uncertainty-cc/Recoil-Motor-Controller/hardware/README.md

### TODOs

 - [ ] Add more caps to 12V rail and over voltage diode to prevent voltage spike shoot through AMS1117.
