uncertainty-cc/Recoil-Motor-Controller/firmware/README.md

## TODO

 - [ ] DOCS: finish documentation for motor_controller.h and motor_controller.c
 - [ ] ADD: implement velocity control loop in PositionController
 - [ ] ADD: implement host machine software (Web GUI)
 - [ ] ADD: implement LUT linearization for encoder position reading
 - [ ] ADD: implement acceleration and velocity controlled trajectory generation
 - [ ] ADD: safety feature, temperature sense and over-temperature shutdown
