uncertainty-cc/Recoil-Motor-Controller/sim/current_domain.gif

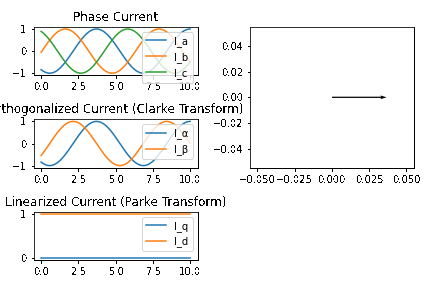
sim/current_domain.gif
