uncertainty-cc/Recoil-Motor-Controller/sim/voltage_domain.gif

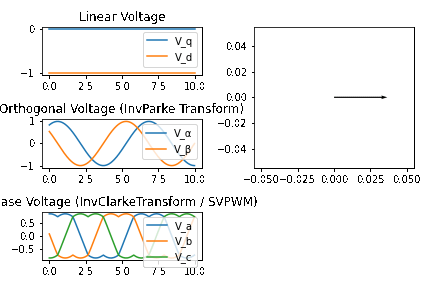
sim/voltage_domain.gif
