uncertainty-cc/Recoil-Motor-Controller/hardware/Recoil-Motor-Controller-G431-DRV8350RS/Schematic_Recoil Motor Controller G431 DRV8350RS v1.1.pdf

## Microcontroller

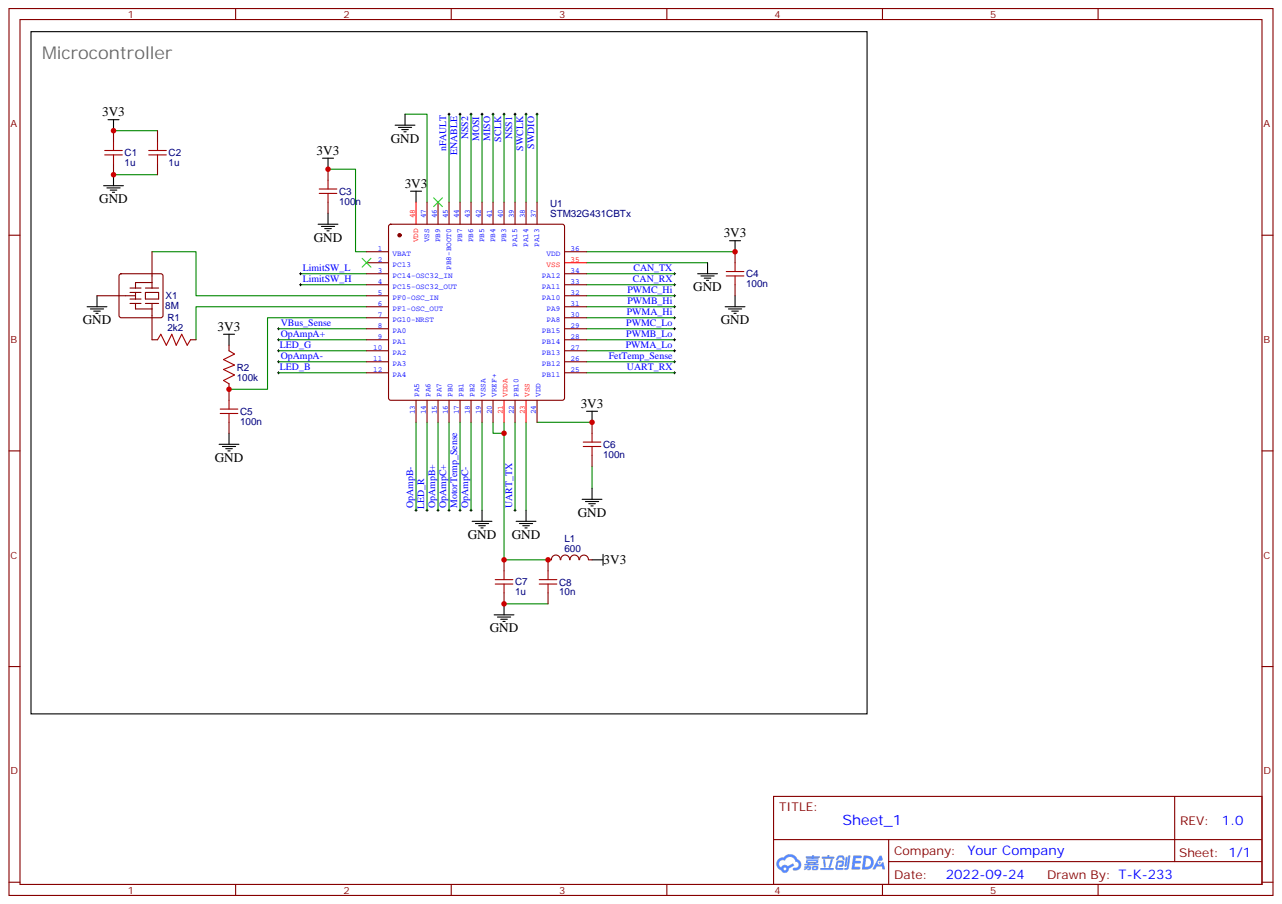
[picture p3: page 1]

## CAN

## CAN Transciever

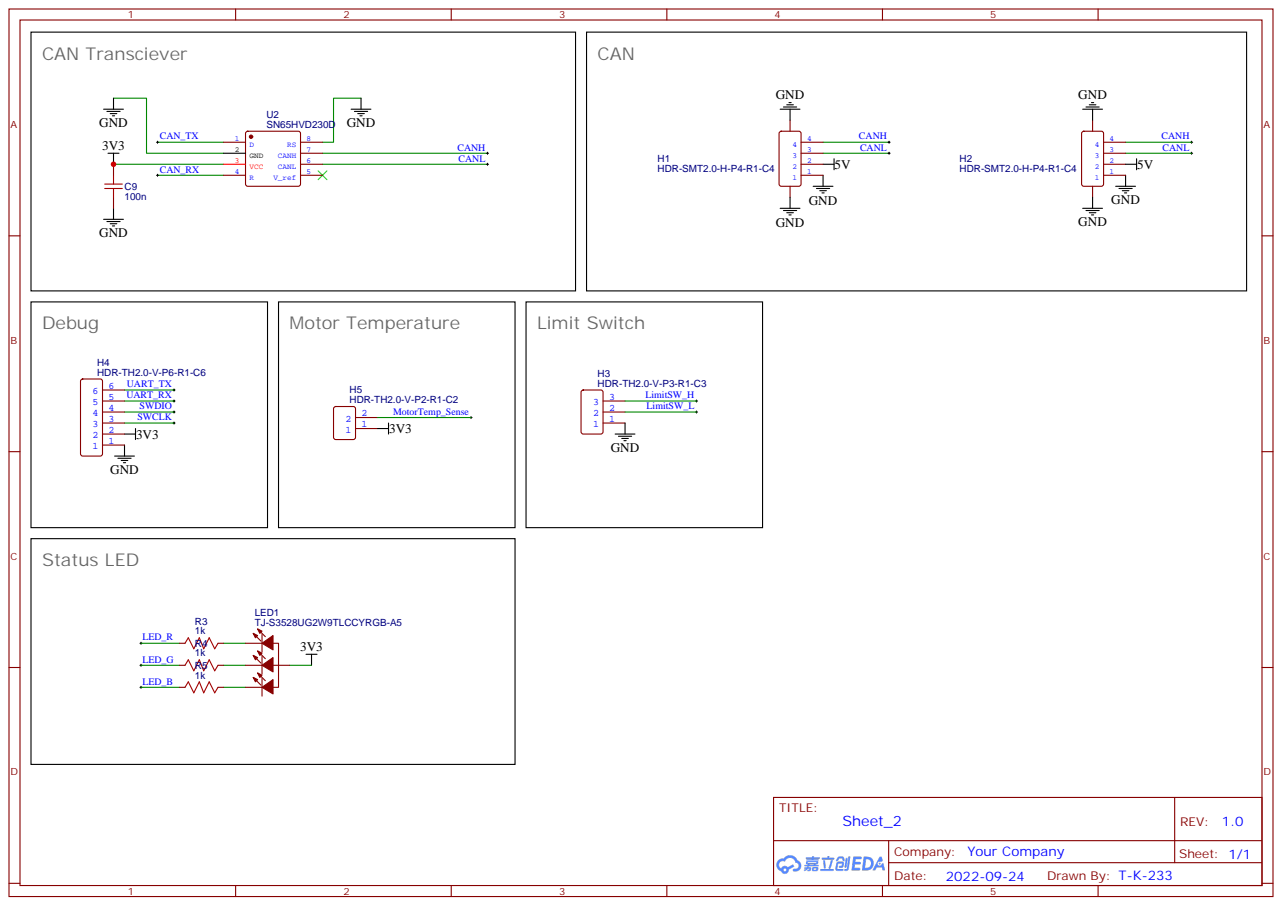
[picture p4: page 2]

## 3V3 Supply

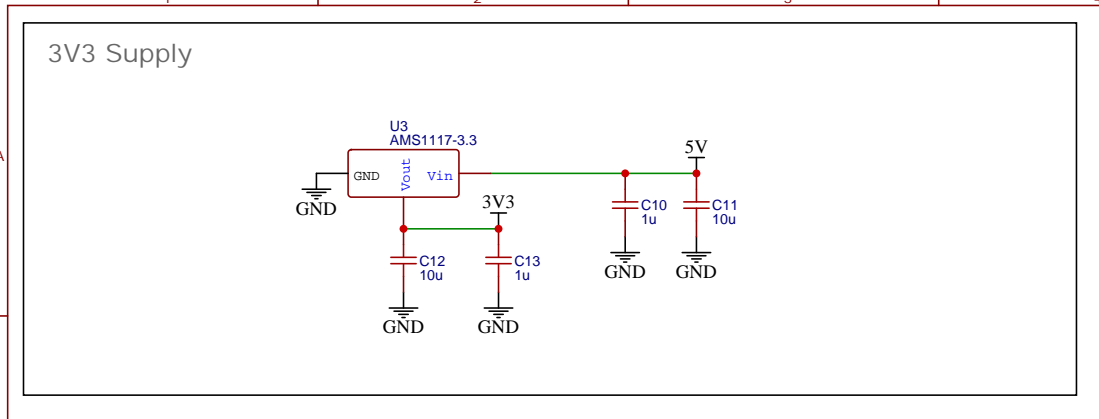
[picture p5: page 3]

## Gate Driver

## Bulk Caps

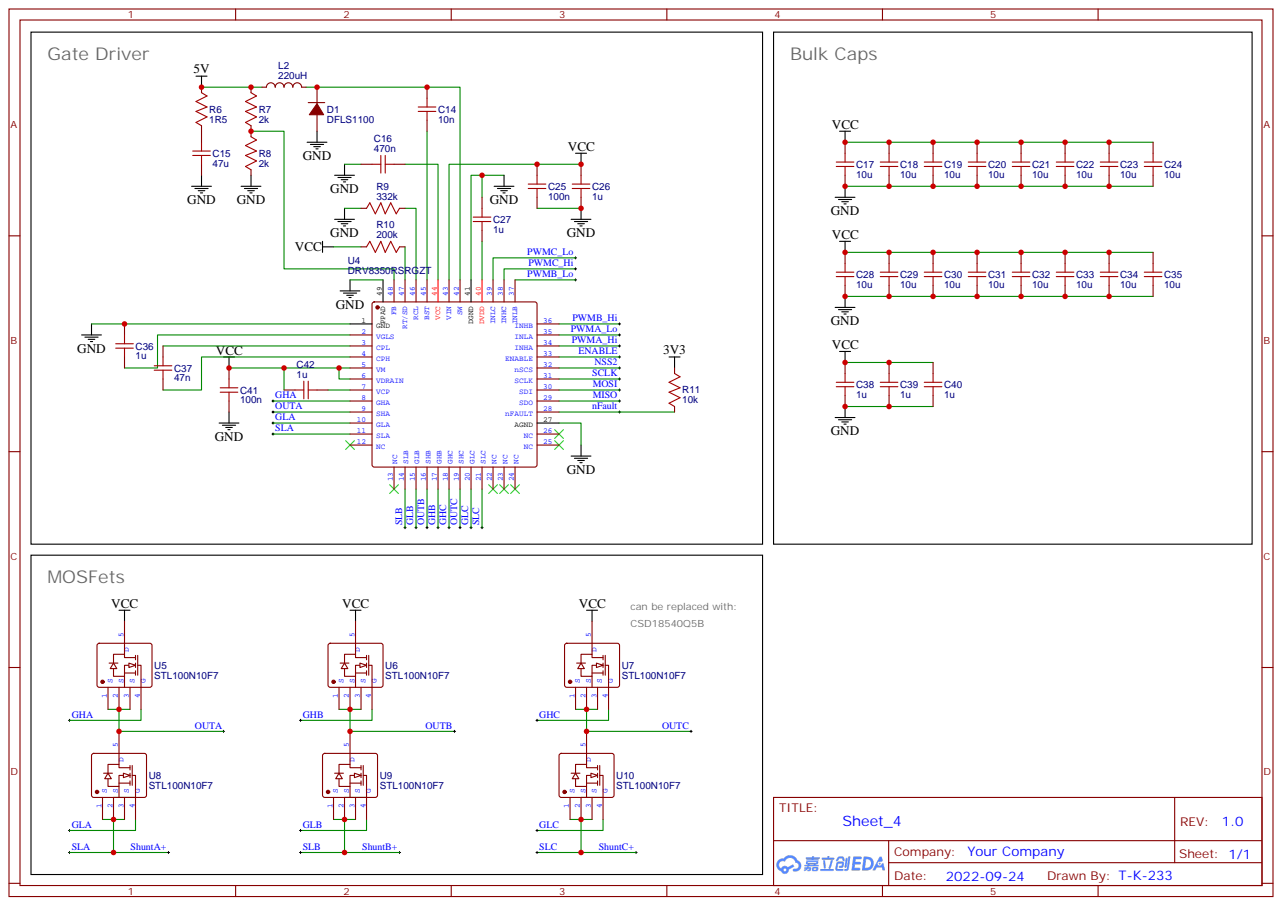
[picture p6: page 4]

can be replaced with:
CSD18540Q5B

## Current Sense

## Voltage Sense

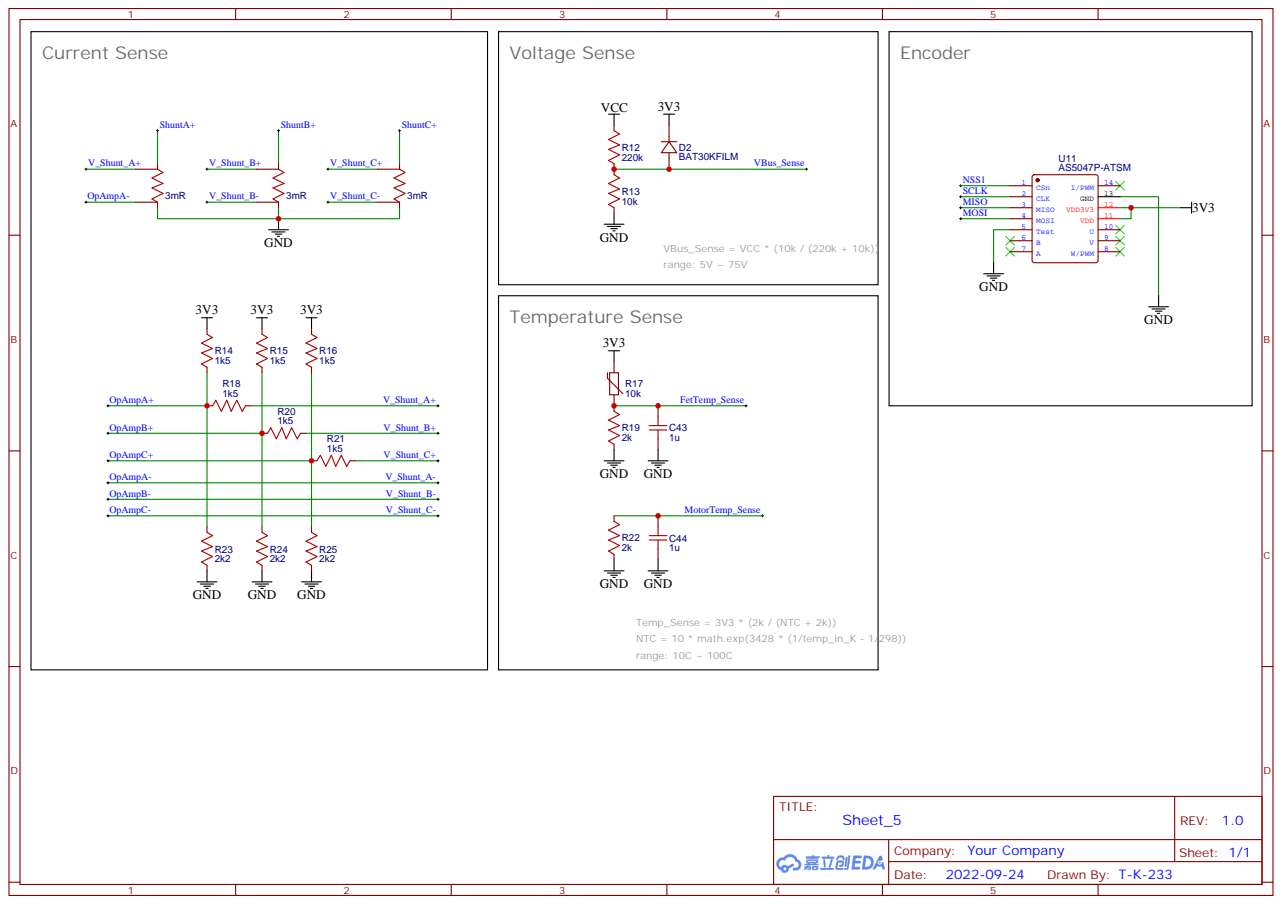
[picture p7: page 5]
