uncertainty-cc/Recoil-Motor-Controller/(list of files, drawings)

Other design files:
hardware/Recoil-Motor-Controller-G431-DRV8350RS/PCB_Recoil Motor Controller G431 DRV8350RS v1.1.pcbdoc
