uncertainty-cc/Recoil-Motor-Controller/firmware/Recoil-Motor-Controller-B-G431B-ESC1/Core/Inc/main.h

#define GPIO_CAN_TERM_Pin GPIO_PIN_14
#define GPIO_CAN_TERM_GPIO_Port GPIOC
#define ADC_POT_Pin GPIO_PIN_12
#define ADC_POT_GPIO_Port GPIOB
#define GPIO_BUTTON_Pin GPIO_PIN_10
#define GPIO_BUTTON_GPIO_Port GPIOC
