uncertainty-cc/Recoil-Motor-Controller/firmware/Recoil-Motor-Controller-B-G431B-ESC1/Core/Src/current_controller.c

#include "current_controller.h"


HAL_StatusTypeDef CurrentController_init(CurrentController *controller) {
  controller->i_limit = 20.f;

  // kp ki should be set through CAN bus.
  // kp = bandwidth * 2 * pi * phase_inductance
  // ki = phase_resistance / phase_inductance
  // for the derivation of equation,
  // @see https://notes.tk233.xyz/motor-control/recoil-foc-motor-controller/0x00.-theory-of-operation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
  controller->i_kp = (1000.f * 2 * M_PI * MOTOR_PHASE_INDUCTANCE);
  controller->i_ki = MOTOR_PHASE_RESISTANCE / MOTOR_PHASE_INDUCTANCE;

  controller->i_a_measured = 0.f;
  controller->i_b_measured = 0.f;
  controller->i_c_measured = 0.f;
  controller->v_a_setpoint = 0.f;
  controller->v_b_setpoint = 0.f;
  controller->v_c_setpoint = 0.f;

  controller->i_alpha_measured = 0.f;
  controller->i_beta_measured = 0.f;
  controller->v_alpha_setpoint = 0.f;
  controller->v_beta_setpoint = 0.f;

  controller->v_q_target = 0.f;
  controller->v_d_target = 0.f;
  controller->v_q_setpoint = 0.f;
  controller->v_d_setpoint = 0.f;

  controller->i_q_target = 0.f;
  controller->i_d_target = 0.f;
  controller->i_q_measured = 0.f;
  controller->i_d_measured = 0.f;
  controller->i_q_setpoint = 0.f;
  controller->i_d_setpoint = 0.f;

  controller->i_q_integrator = 0.f;
  controller->i_d_integrator = 0.f;

  return HAL_OK;
}

void CurrentController_update(CurrentController *controller, Mode mode, float sin_theta, float cos_theta, float v_bus) {
  // Perform Clark transformation to convert currents from 3-phase to alpha-beta frame.
  FOC_clarkTransform(
    &controller->i_alpha_measured,
    &controller->i_beta_measured,
    controller->i_a_measured,
    controller->i_b_measured,
    controller->i_c_measured);

  // Perform Park transformation to convert currents from alpha-beta to DQ frame.
  FOC_parkTransform(
        &controller->i_q_measured,
        &controller->i_d_measured,
        controller->i_alpha_measured,
        controller->i_beta_measured,
        sin_theta, cos_theta);

  // Clamp Q and D axis current setpoints.
  controller->i_q_setpoint = clampf(controller->i_q_target, -controller->i_limit, controller->i_limit);
  controller->i_d_setpoint = clampf(controller->i_d_target, -controller->i_limit, controller->i_limit);

  if (mode != MODE_VQD_OVERRIDE) {
    float i_q_error = controller->i_q_setpoint - controller->i_q_measured;
    float i_d_error = controller->i_d_setpoint - controller->i_d_measured;

    // We divide i_q_error by the commutation frequency to convert it in unit of A/s.
    // We are using series PI controller, so both Kp and Ki are applied to the integrator.
    controller->i_q_integrator = clampf(
        controller->i_q_integrator + controller->i_kp * controller->i_ki * i_q_error / (float)COMMUTATION_FREQ, -v_bus, v_bus);
    controller->i_d_integrator = clampf(
        controller->i_d_integrator + controller->i_kp * controller->i_ki * i_d_error / (float)COMMUTATION_FREQ, -v_bus, v_bus);

    controller->v_q_target = controller->i_kp * i_q_error + controller->i_q_integrator;
    controller->v_d_target = controller->i_kp * i_d_error + controller->i_d_integrator;
  }
  else {
    /*
     * user sets `controller->v_q_target` and `controller->v_d_target`
     */
  }

  // Calculate over-modulation factor k for voltage clamping based on bus voltage and setpoints.
  float k = 1.f;
  if (v_bus > 0.f) {
    // CSVPWM over-modulation
    float v_max_sq = v_bus * v_bus * 1.15f;
    float v_norm = (
        (controller->v_q_target * controller->v_q_target)
        + (controller->v_d_target * controller->v_d_target)
        );
    if (v_norm > v_max_sq) {
      k = sqrtf(fabsf(v_norm / v_max_sq));
    }
  }
  controller->v_q_setpoint = k * controller->v_q_target;
  controller->v_d_setpoint = k * controller->v_d_target;

  if (mode != MODE_VALPHABETA_OVERRIDE && mode != MODE_CALIBRATION) {
    // Perform inverse Park transformation to convert phase voltages from DQ frame to alpha-beta frame.
    FOC_invParkTransform(
        &controller->v_alpha_setpoint,
        &controller->v_beta_setpoint,
        controller->v_q_setpoint,
        controller->v_d_setpoint,
        sin_theta, cos_theta);
  }
  else {
    // Calibration mode sets `v_alpha_setpoint` and `v_beta_setpoint` directly
    /*
     * user sets `controller->v_alpha_setpoint` and `controller->v_beta_setpoint`
     */
  }

  if (mode != MODE_VABC_OVERRIDE) {
    // Perform inverse Clark transformation with SVPWM modulation to convert voltage from alpha-beta frame to 3-phase.
    FOC_invClarkSVPWM(
        &controller->v_a_setpoint,
        &controller->v_b_setpoint,
        &controller->v_c_setpoint,
        controller->v_alpha_setpoint,
        controller->v_beta_setpoint);
  }
  else {
    /*
     * user sets `controller->v_a_setpoint`, `controller->v_b_setpoint`,
     * and `controller->v_c_setpoint`
     */
  }
}
