uncertainty-cc/Recoil-Motor-Controller/firmware/Recoil-Motor-Controller-B-G431B-ESC1/Core/Src/encoder.c

/*
 * encoder.c
 *
 *  Created on: Aug 24, 2022
 *      Author: TK
 */

#include "encoder.h"


HAL_StatusTypeDef Encoder_init(Encoder *encoder, I2C_HandleTypeDef *hi2c) {
  encoder->hi2c = hi2c;
//  encoder->i2c_update_counter = 0;

  encoder->cpr = ENCODER_DIRECTION * (1 << ENCODER_PRECISION_BITS);  // 12 bit precision

  encoder->position_offset = 0.f;

  // defaults to be 2000 Hz cutoff, out of 10 kHz loop
  encoder->velocity_filter_alpha = 0.7153904566639707f;

  encoder->position_raw = 0;
  encoder->n_rotations = 0;

  encoder->position = 0.f;
  encoder->velocity = 0.f;

  Encoder_resetFluxOffset(encoder);

  HAL_StatusTypeDef status = HAL_ERROR;
  while (status) {
    HAL_I2C_Init(encoder->hi2c);

    // wait for I2C device to power up
    HAL_Delay(100);

    status = HAL_I2C_Mem_Read(encoder->hi2c, AS5600_I2C_ADDR << 1, AS5600_ANGLE_ADDR, I2C_MEMADD_SIZE_8BIT, encoder->i2c_buffer, 2, 100);
  }

  return status;
}

void Encoder_resetFluxOffset(Encoder *encoder) {
  encoder->n_rotations = 0;
  encoder->flux_offset = 0.f;
  memset((uint8_t *)encoder->flux_offset_table, 0, ENCODER_LUT_ENTRIES*sizeof(float));
}

HAL_StatusTypeDef Encoder_update(Encoder *encoder) {
  // commutation frequency (10 kHz) should be slower than I2C transfer speed (~12.86 kHz)

  // Read the raw reading from the I2C sensor, the range should be [0, cpr-1].
  // safety check to handle encoder data frame mismatch error
  uint16_t raw_reading = (((uint16_t)encoder->i2c_buffer[0]) << 8) | encoder->i2c_buffer[1];
  if (raw_reading >= abs(encoder->cpr)) {
    return 0x04;
  }

  // TODO: implement encoder lut-table Linearization

  // I2C takes ~77.75 us (12.86 kHz) to finish one transaction
  HAL_I2C_Master_Receive_IT(encoder->hi2c, AS5600_I2C_ADDR << 1, encoder->i2c_buffer, 2);


  // Calculate the change in reading
  int16_t reading_delta = encoder->position_raw - raw_reading;

  // Handle multi-rotation crossing.
  if (abs(reading_delta) >= abs(encoder->cpr / 2)) {
    encoder->n_rotations += ((encoder->cpr * reading_delta) > 0) ? 1 : -1;
  }
  encoder->position_raw = raw_reading;

  // Convert the raw position to position in radians (rad)
  float position = (((float)raw_reading / (float)encoder->cpr) + encoder->n_rotations) * (M_2PI_F);

  // Update the delta position
  float delta_position = position - encoder->position;
  encoder->position = position;

  // Update the filtered velocity
  float velocity = delta_position * (float)COMMUTATION_FREQ;
  encoder->velocity += encoder->velocity_filter_alpha * (velocity - encoder->velocity);

  return HAL_OK;
}
