uncertainty-cc/Recoil-Motor-Controller/firmware/Recoil-Motor-Controller-B-G431B-ESC1/Core/Src/position_controller.c

/*
* position_controller.c
*
*  Created on: Aug 27, 2022
*      Author: TK
*/

#include "position_controller.h"

HAL_StatusTypeDef PositionController_init(PositionController *controller) {
  controller->update_counter = 0;
  controller->gear_ratio = 1.f;

  // defaults to 50 Hz cutoff frequency, out of 2000 Hz position control loop
  controller->torque_filter_alpha = 0.145364f;

  controller->position_kp = 1.f;
  controller->position_ki = 0.f;

  controller->velocity_kp = .1f;
  controller->velocity_ki = 0.f;

  controller->torque_limit = 1.f;

  controller->velocity_limit = 20.f;

  controller->position_limit_lower = -INFINITY;
  controller->position_limit_upper = INFINITY;
  controller->position_offset = 0.f;

  controller->torque_target = 0.f;
  controller->torque_setpoint = 0.f;
  controller->velocity_target = 0.f;
  controller->velocity_setpoint = 0.f;
  controller->position_target = 0.f;
  controller->position_setpoint = 0.f;

  controller->position_integrator = 0.f;
  controller->velocity_integrator = 0.f;

  return HAL_OK;
}

void PositionController_update(PositionController *controller, Mode mode) {
  controller->update_counter += 1;
  if (controller->update_counter >= (COMMUTATION_FREQ / POSITION_UPDATE_FREQ)) {
    controller->update_counter = 0;
  }
  else {
    return;
  }
  //  acceleration = trajectory_follower(command_position, command_velocity)
  //  control_velocity = command_velocity OR control_velocity + acceleration * dt OR 0.0
  //  control_position = command_position OR control_position + control_velocity * dt
  //  position_error = control_position - feedback_position
  //  velocity_error = control_velocity - feedback_velocity
  //  position_integrator = limit(position_integrator + ki * position_error * dt, ilimit)
  //  torque = position_integrator +
  //           kp * kp_scale * position_error +
  //           kd * kd_scale * velocity_error +
  //           command_torque

  float torque_target = 0.f;
  if (mode == MODE_POSITION) {
    controller->position_setpoint = clampf(
        controller->position_target,
        controller->position_limit_lower,
        controller->position_limit_upper);

    float position_error = controller->position_setpoint - controller->position_measured;
    float velocity_error = 0.f - controller->velocity_measured;

    controller->position_integrator = clampf(
        controller->position_integrator + controller->position_ki * position_error,
        -controller->torque_limit,
        controller->torque_limit);

    torque_target =
        controller->position_kp * position_error
        + controller->velocity_kp * velocity_error
        + controller->position_integrator
        // feed forward torque
        + controller->torque_target;
  }
  else if (mode == MODE_VELOCITY) {
    controller->velocity_setpoint = clampf(
        controller->velocity_target,
        -controller->velocity_limit,
        controller->velocity_limit);

    float velocity_error = controller->velocity_setpoint - controller->velocity_measured;
    torque_target = controller->velocity_kp * velocity_error;
  }
  else {
    // MODE_TORQUE
    /*
     * user sets `controller->torque_target`
     */
    torque_target = controller->torque_target;
  }

  // apply EMA filter
  float torque_target_filtered = controller->torque_filter_alpha * torque_target;
  torque_target_filtered += (1.0f - controller->torque_filter_alpha) * controller->torque_setpoint;

  controller->torque_setpoint = clampf(
      torque_target_filtered,
      -controller->torque_limit,
      controller->torque_limit);
}
