uncertainty-cc/Recoil-Motor-Controller/firmware/Recoil-Motor-Controller-B-G431B-ESC1/Core/Inc/position_controller.h

/*
 * foc.h
 *
 *  Created on: Aug 2, 2022
 *      Author: TK
 */

#ifndef INC_POSITION_CONTROLLER_H_
#define INC_POSITION_CONTROLLER_H_

#include <stdint.h>

#include "stm32g4xx_hal.h"
#include "foc_math.h"
#include "motor_controller_conf.h"


/**
 * @brief PositionController object.
 */
typedef struct {
  uint32_t update_counter;
  float gear_ratio;

  float position_kp;
  float position_ki;
  float velocity_kp;
  float velocity_ki;

  float torque_limit;
  float velocity_limit;
  float position_limit_lower;
  float position_limit_upper;
  float position_offset;

  float torque_target;
  float torque_measured;
  float torque_setpoint;

  float velocity_target;
  float velocity_measured;
  float velocity_setpoint;

  float position_target;
  float position_measured;
  float position_setpoint;

  float position_integrator;
  float velocity_integrator;
  
  float torque_filter_alpha;
} PositionController;


static inline void PositionController_reset(PositionController *controller) {
  controller->position_setpoint = controller->position_measured;
  controller->position_integrator = 0.f;
  controller->velocity_setpoint = controller->velocity_measured;
  controller->velocity_integrator = 0.f;
  controller->torque_setpoint = 0.f;
}

/**
 * @brief Get the measured torque.
 *
 * @param controller Pointer to the PositionController struct.
 * @return The measured torque in Newton-meter (Nm).
 */
static inline float PositionController_getTorqueMeasured(PositionController *controller) {
  return controller->torque_measured;
}

/**
 * @brief Get the measured velocity.
 *
 * @param controller Pointer to the PositionController struct.
 * @return The measured velocity in radian per second (rad/s).
 */
static inline float PositionController_getVelocityMeasured(PositionController *controller) {
  return controller->velocity_measured;
}

/**
 * @brief Get the measured position.
 *
 * @param controller Pointer to the PositionController struct.
 * @return The measured position in radians (rad).
 */
static inline float PositionController_getPositionMeasured(PositionController *controller) {
  return controller->position_measured - controller->position_offset;
}

/**
 * @brief Set the target torque.
 *
 * @param controller Pointer to the PositionController struct.
 * @param target The target torque in Newton-meter (Nm).
 */
static inline void PositionController_setTorqueTarget(PositionController *controller, float target) {
  controller->torque_target = target;
}

/**
 * @brief Set the target velocity.
 *
 * @param controller Pointer to the PositionController struct.
 * @param target The target velocity in radian per second (rad/s).
 */
static inline void PositionController_setVelocityTarget(PositionController *controller, float target) {
  controller->velocity_target = target;
}

/**
 * @brief Set the target position.
 *
 * @param controller Pointer to the PositionController struct.
 * @param target The target position in radians (rad).
 */
static inline void PositionController_setPositionTarget(PositionController *controller, float target) {
  controller->position_target = target + controller->position_offset;
}

/**
 * @brief Initialize the PositionController instance with default values.
 *
 * This function initializes a PositionController struct with default initial position, velocity
 * and torque limits, and PID gains for the position control loop.
 *
 * @param controller Pointer to the PositionController struct.
 * @return Status of the initialization process. HAL_OK if successful.
 */
HAL_StatusTypeDef PositionController_init(PositionController *controller);

/**
 * @brief Update the PositionController state based on the specified mode and inputs.
 *
 * This function updates the position controller with the given mode.
 * It calculates the control torque based on the specified control mode
 * (position, velocity, or torque) and the corresponding control parameters.
 *
 * If mode is MODE_POSITION:
 *   - Sets the position setpoint based on the target position and position limits.
 *   - Computes position and velocity errors.
 *   - Integrates the position error and limits the integrator value.
 *   - Calculates the control torque based on position and velocity errors and PID gains.
 *
 * If mode is MODE_VELOCITY (not implemented in this function):
 *   - TODO: Implement velocity control loop.
 *
 * If mode is MODE_TORQUE:
 *   - The user should have previously set the torque target directly in `controller->torque_target`.
 *   - No further calculations are performed in this function for torque control.
 *
 * @param controller Pointer to the PositionController struct.
 * @param mode The operating mode of the controller.
 */
void PositionController_update(PositionController *controller, Mode mode);

#endif /* INC_POSITION_CONTROLLER_H_ */
