uncertainty-cc/Recoil-Motor-Controller/firmware/Recoil-Motor-Controller-G431-DRV8350RS/Core/Src/motor.c

/*
 * motor.c
 *
 *  Created on: Oct 13, 2022
 *      Author: TK
 */


#include "motor.h"


void Motor_init(Motor *motor) {
  motor->pole_pairs = 14;
  motor->kv_rating = 150;

  motor->flux_angle_offset = 1.560145f;
}
