uncertainty-cc/Recoil-Motor-Controller/firmware/Recoil-Motor-Controller-G431-DRV8353RS/Core/Inc/app.h

/*
 * app.h
 *
 *  Created on: Sep 26, 2023
 *      Author: tk
 */

#ifndef INC_APP_H_
#define INC_APP_H_

#include <string.h>
#include <stdio.h>

#include "main.h"
#include "motor_controller_conf.h"
#include "motor_controller.h"

void APP_init();

void APP_main();


#endif /* INC_APP_H_ */
