uncertainty-cc/Recoil-Motor-Controller/(commit log)

2022-11-04 FIX: fix Flash init sequence
    [Recoil-Motor-Controller-G431-DRV8350RS Debug.cfg]
2022-11-04 ADD: adding velocity & acceleration limit
2022-11-17 ADD: change encoder filter to PLL
2022-11-24 FIX: fix current loop
    [app.c, current_controller.c, current_controller.h, encoder.c, encoder.h, motor_controller.c, motor_controller.h, motor_controller_conf.h]
2022-11-24 FIX: fix position loop
    [app.c, motor_controller.c, motor_controller.h, motor_controller_conf.h, position_controller.c, position_controller.h]
2022-11-24 FIX: final patch, bump to v2.0.0
    [app.c, current_controller.c, encoder.c, motor_controller.c, motor_controller_conf.h, position_controller.c, position_controller.h]
2022-11-26 ADD: change LED to PWM; remap CAN func ID
2022-12-07 FIX: small change to initialization routine
    [app.c, motor_controller.c]
2022-12-07 ADD: add velocity loop
2022-12-08 ADD: four motor working for EE106
2023-01-24 ADD: improve current loop
2023-02-20 ADD: add support for different motor profile, M6C12 and 5010-310KV now working
2023-04-03 ADD: add new frame format documentation
2023-05-26 CHECKPOINT: before changing to integer encoder handling
2023-05-26 ADD: implement correct parametric PI current loop!
    [app.c, current_controller.c, encoder.c, motor_controller.c, motor_controller_conf.h]
2023-05-26 ADD: switch to new IDE version
2023-05-31 FIX: add safety check to verify flash load success
    [motor_controller.c]
2023-05-31 FIX: fix encoder filter initialization script
    [encoder.c]
2023-05-31 FIX: fix watchdog state machine error
    [app.c, motor_controller.c, motor_controller_conf.h]
2023-08-30 FIX: add encoder delay and fix I2C bus hang issue
    [Recoil-Motor-Controller-B-G431B-ESC1.ioc, app.c, motor_controller.c]
2023-08-30 ADD: revert application init settings
    [app.c]
2023-10-06 ADD: add modification to DRV8353, fix current sampling bug
    [Recoil-Motor-Controller-G431-DRV8353RS Debug.cfg]
2023-10-09 ADD: add gearratio etc.
2023-10-09 ADD: add gear_ratio and refactor code
2023-10-09 ADD: stage
2023-10-16 ADD: verify that gear ratio now works
2024-03-01 FIX: fix position PD control loop filter logic
    [app.c, encoder.c, motor_controller_conf.h]
2024-03-11 ADD: add fixed16 number format for fast communication
    [app.c, foc_math.h, motor_controller.c, motor_controller_conf.h]
2024-05-07 HOTPATCH: reverting lost code: adding position offset entry
    [motor_controller_conf.h, position_controller.h]
2024-05-07 HOTPATCH: adding back position offset logic and fast frames
2024-05-16 FIX: fix controller flash reading missing field
    [motor_controller.c, motor_controller_conf.h]
2024-05-16 FIX: firmware version should always be hard-coded
    [motor_controller.c]
2025-01-12 FIX: trying to fix current loop position compensation error
    [app.c, encoder.c, motor_controller.c]
2025-01-12 FIX: high velocity high torque performance bug
    [app.c, motor_controller.c, motor_controller_conf.h, position_controller.c]
2025-01-19 FIX: fixed encoder i2c logic, flashed to robot
    [Recoil-Motor-Controller-B-G431B-ESC1.ioc, app.c, encoder.c, motor_controller.c, motor_controller_conf.h]
2025-01-20 FIX: update default values
    [current_controller.c, position_controller.c]
2025-01-21 MAJOR: add EMA filter, change register MMIO mapping
2025-01-21 ADD: STM32 stuff
2025-01-21 ADD: remove fast frame
2025-01-21 ADD: STM32 poop
2025-01-21 FIX: slight change on magic number to avoid motor runaway
    [motor_controller.c]
2025-01-21 FIX: VQD override state switch bug
    [current_controller.h]
2025-01-21 ADD: measured and adjusted motor resistance
2025-01-21 ADD: stm32 poops, version flashed to robot
2025-01-22 FIX: trying to fix encoder craziness, adjust NVIC priorities
    [Recoil-Motor-Controller-B-G431B-ESC1.ioc, encoder.c, encoder.h, motor_controller.c, motor_controller_conf.h]
2025-02-24 ADD: change FOC loop to be 10 kHz, same as I2C encoder reading
2025-02-26 FIX: remove the torque magic number, update to use profiled motor parameters
    [motor.c, motor.h, motor_controller.c, motor_controller_conf.h, motor_profiles.h]
2025-02-27 ADD: change CAN frame to be compatible with CANopen
2025-02-27 ADD: update FLASH frame behavior
2025-02-27 FIX: kinda fixed motor out of control
    ERRATA: motor still freaks out under high RPM when PD gain, torque limit, and current limits are set too high, see video on Notion
    [motor_controller.c]
2025-02-27 FIX: motor going crazy due to encoder velocity filter BW too low
    [encoder.c]
2025-03-01 FIX: correct field name
    [motor_controller_conf.h]
