uncertainty-cc/Recoil-Motor-Controller/(notices)

Notices in the files:
firmware/Recoil-Motor-Controller-B-G431B-ESC1/Core/Inc/main.h:
Copyright (c) 2022 STMicroelectronics.
All rights reserved.
This software is licensed under terms that can be found in the LICENSE file
